DanielHeEGG/MAST/Hardware/MAST.kicad_pcb

## KiCad design Hardware/MAST.kicad_pcb (2021-07-17)

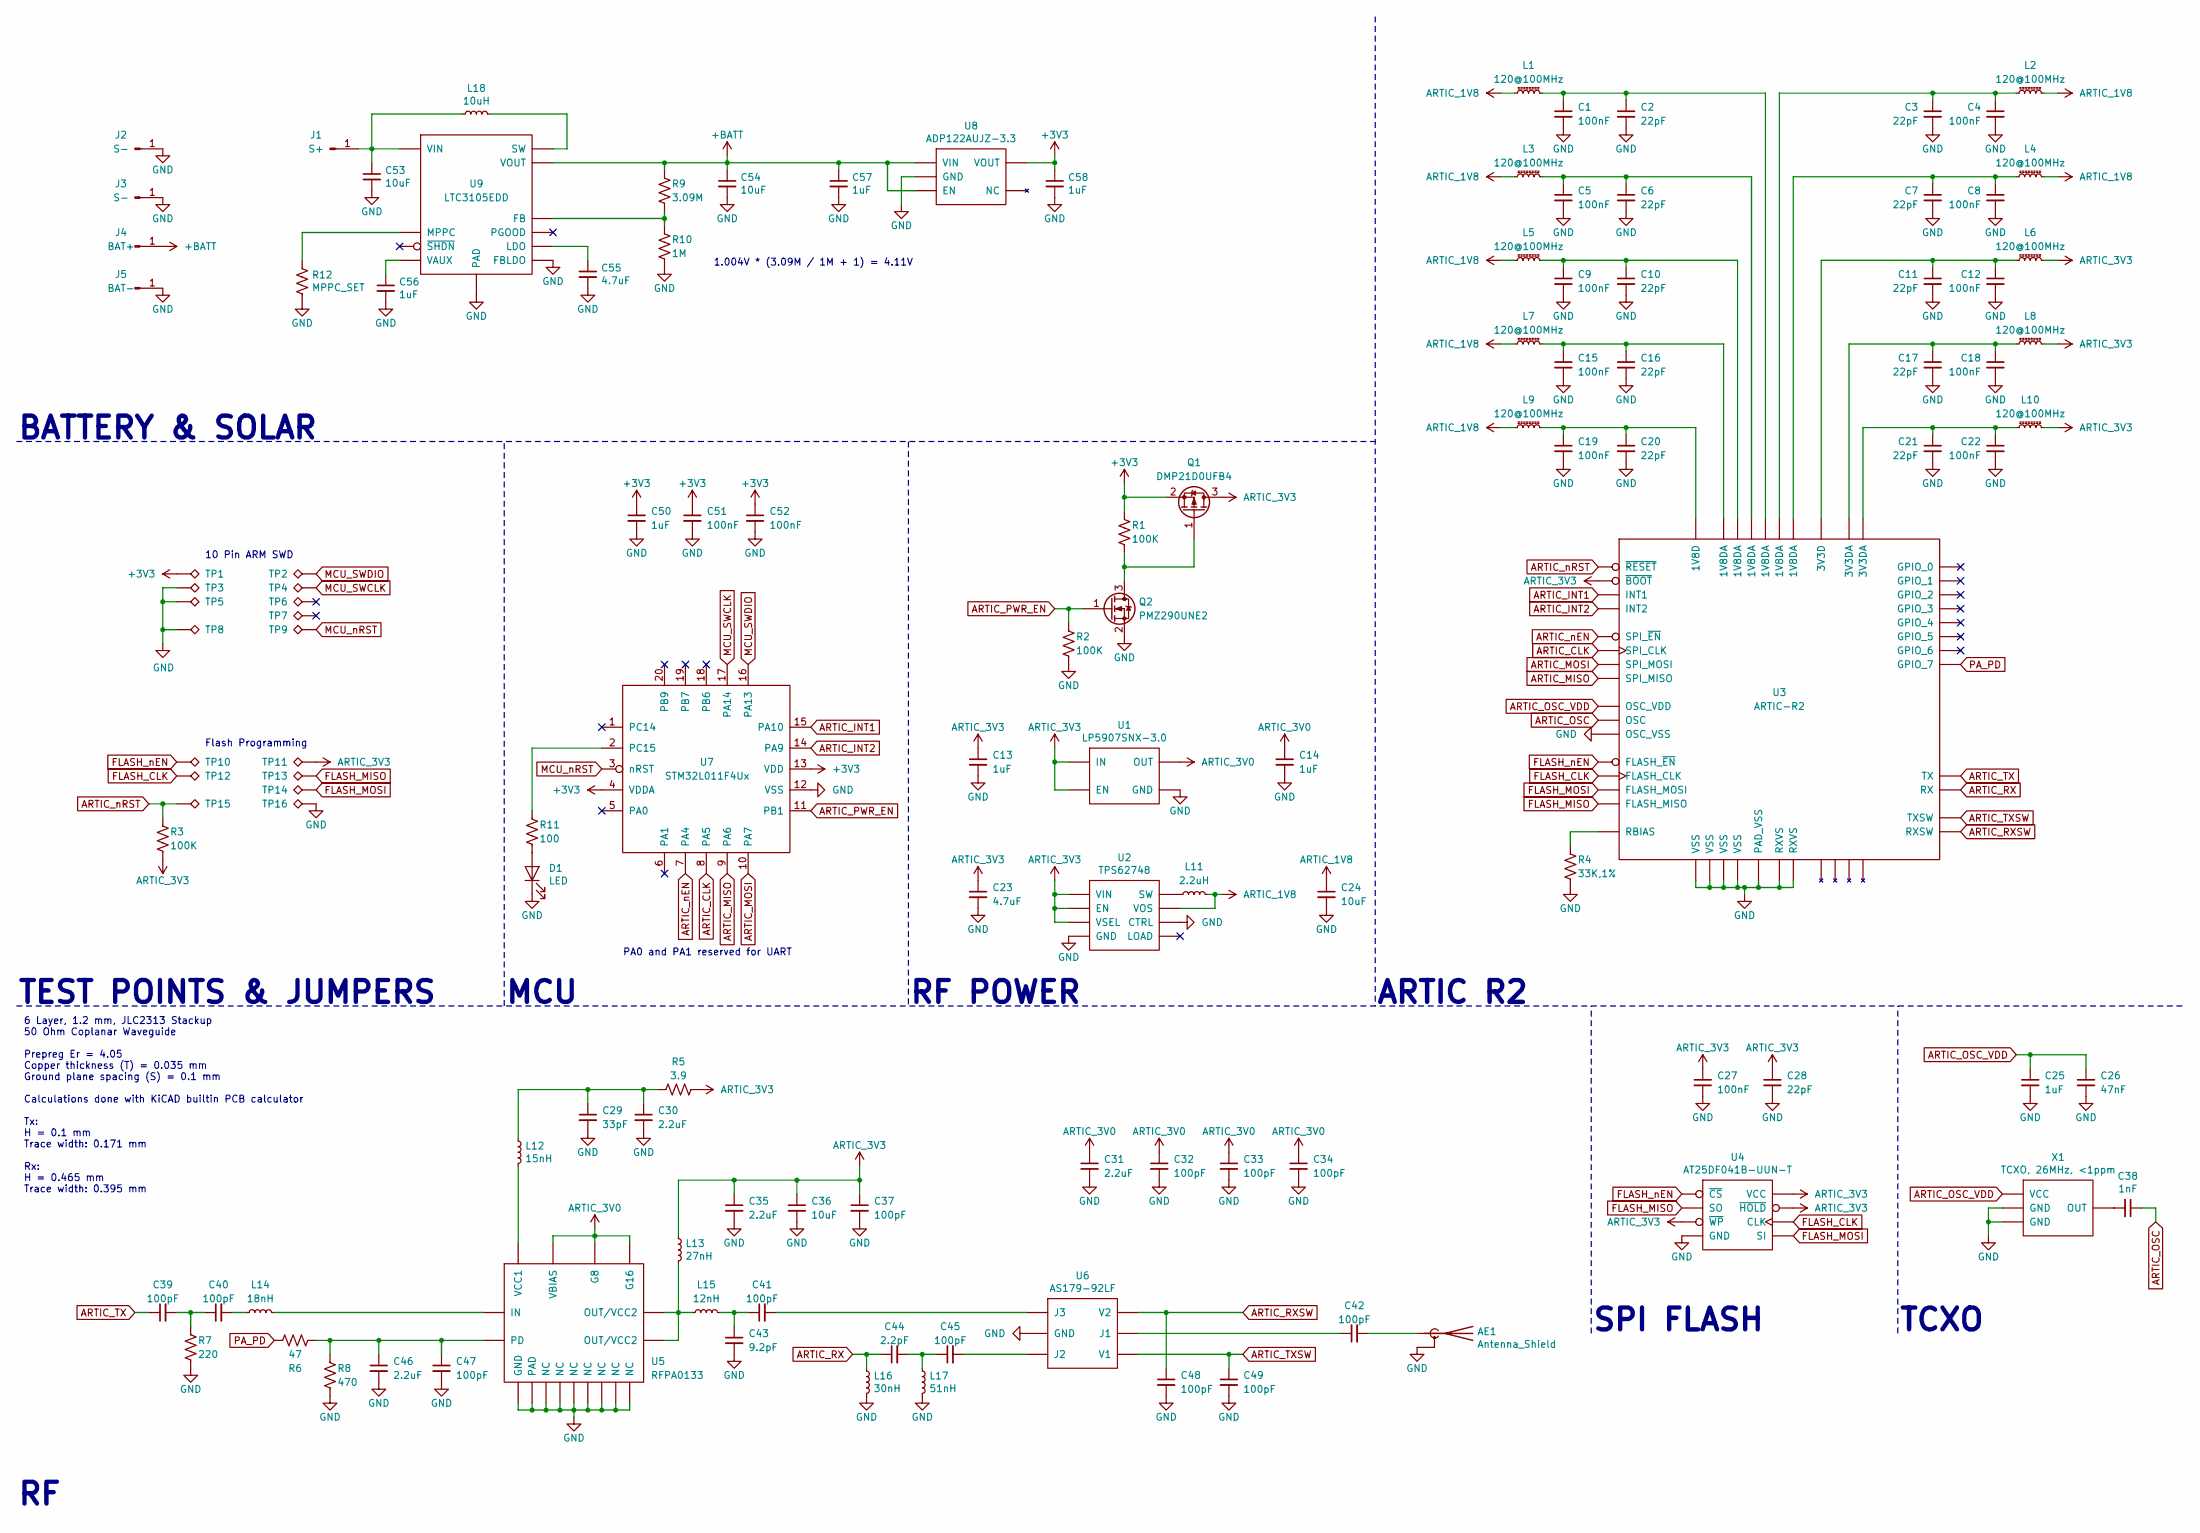
[picture p1: schematic MAST.sch]

Parts:
AE1: Antenna_Shield; U.FL_Hirose_U.FL-R-SMT-1_Vertical; Part# U.FL-R-SMT-1(10); Digikey# H11891TR-ND
C1, C4, C5, C8, C9, C12, C15, C18, C19, C22, C27, C51, C52: 100nF; C_0201_0603Metric; Part# CC0201MRX5R5BB104; LCSC# C277512
C2, C3, C6, C7, C10, C11, C16, C17, C20, C21, C28: 22pF; C_0201_0603Metric; Part# CC0201GRNPO9BN220; Digikey# 311-3681-2-ND
C13, C14, C25, C50, C56, C57, C58: 1uF; C_0201_0603Metric; Part# CC0201MRX5R5BB105; Digikey# 311-1613-2-ND
C23, C55: 4.7uF; C_0402_1005Metric; Part# CC0402KRX5R6BB475; Digikey# 311-3477-2-ND
C24, C36, C53, C54: 10uF; C_0402_1005Metric; Part# CC0402MRX5R6BB106; Digikey# 311-3480-2-ND
C26: 47nF; C_0201_0603Metric; Part# CC0201KRX5R6BB473; Digikey# 13-CC0201KRX5R6BB473TR-ND
C29: 33pF; C_0201_0603Metric; Part# CC0201JRNPO8BN330; Digikey# 311-1381-2-ND
C30, C31, C35, C46: 2.2uF; C_0402_1005Metric; Part# CC0402MRX5R6BB225; Digikey# 311-1733-2-ND
C32, C33, C34, C37, C39, C40, C41, C42, C45, C47, C48, C49: 100pF; C_0201_0603Metric; Part# CC0201JRNPO8BN101; Digikey# 311-1382-2-ND
C38: 1nF; C_0201_0603Metric; Part# CC0201KRX7R7BB102; Digikey# 311-1399-2-ND
C43: 9.2pF; C_0201_0603Metric; Part# GJM0335C1E9R2CB01D; Digikey# 490-17292-2-ND
C44: 2.2pF; C_0201_0603Metric; Part# CC0201BRNPO8BN2R2; Digikey# 311-3289-2-ND
D1: LED; LED_0402_1005Metric; Part# 16-213/SURC/S530-A3/TR8; LCSC# C136765
J1: S+; EP_5x2mm
J2, J3: S-; EP_3x2mm
J4: BAT+; EP_3x2mm
J5: BAT-; EP_3x2mm
L1, L2, L3, L4, L5, L6, L7, L8, L9, L10: 120@100MHz; L_0201_0603Metric; Part# BLM03AG121SN1D; Digikey# 490-2557-2-ND
L11: 2.2uH; L_0805_2012Metric; Part# LQM21PN2R2MC0D; Digikey# 490-4994-2-ND
L12: 15nH; L_0201_0603Metric; Part# LQP03TG15NJ02D; Digikey# 490-12895-2-ND
L13: 27nH; L_0201_0603Metric; Part# LQP03TG27NJ02D; Digikey# 490-12942-2-ND
L14: 18nH; L_0201_0603Metric; Part# LQP03TG18NJ02D; Digikey# 490-12896-2-ND
L15: 12nH; L_0201_0603Metric; Part# LQP03TG12NJ02D; Digikey# 490-12894-2-ND
L16: 30nH; L_0201_0603Metric; Part# LQP03TN30NH02D; Digikey# 490-13005-2-ND
L17: 51nH; L_0201_0603Metric; Part# LQP03TN51NH02D; Digikey# 490-13014-2-ND
L18: 10uH; L_0805_2012Metric; Part# LQM21FN100M80L; Digikey# 490-6682-2-ND
Q1: DMP21D0UFB4; SOT-883; Part# DMP21D0UFB4-7B; Digikey# DMP21D0UFB4-7BDITR-ND
Q2: PMZ290UNE2; SOT-883; Part# PMZ290UNE2YL; Digikey# 1727-2233-2-ND
R1, R2, R3: 100K; R_0201_0603Metric; Part# AC0201FR-07100KL; Digikey# YAG3411TR-ND
R4: 33K,1%; R_0201_0603Metric; Part# RC0201FR-0733KL; Digikey# YAG2282TR-ND
R5: 3.9; R_0402_1005Metric; Part# RC0402FR-073R9L; Digikey# 13-RC0402FR-073R9LTR-ND
R6: 47; R_0402_1005Metric; Part# RC0402FR-0747RL; Digikey# 311-47.0LRTR-ND
R7: 220; R_0201_0603Metric; Part# RC0201FR-07220KL; Digikey# YAG2277TR-ND
R8: 470; R_0402_1005Metric; Part# RC0402FR-07470RL; Digikey# 311-470LRTR-ND
R9: 3.09M; R_0201_0603Metric; Part# RC0201FR-073M09L; Digikey# RC0201FR-073M09L-ND
R10: 1M; R_0201_0603Metric; Part# RC0201FR-071ML; Digikey# 311-1MMTR-ND
R11: 100; R_0402_1005Metric; Part# RC0402JR-07100RL; Digikey# 311-100JRTR-ND
R12: MPPC_SET; R_0603_1608Metric
TP1, TP2, TP3, TP4, TP5, TP6, TP7, TP8, TP9, TP10, TP11, TP12, TP13, TP14, TP15, TP16: TestPoint
U1: LP5907SNX-3.0; Texas_X2SON-4_1x1mm_P0.65mm; Part# LP5907SNX-3.0/NOPB; Digikey# 296-39065-2-ND
U2: TPS62748; Texas_DSBGA-8_0.9x1.9mm_Layout2x4_P0.5mm; Part# TPS62748YFPT; Digikey# 296-43000-2-ND
U3: ARTIC-R2; QFN-48-1EP_7x7mm_P0.5mm_EP5.6x5.6mm
U4: AT25DF041B-UUN-T; WLCSP-8_1.58x1.63x0.35mm_Layout3x5_P0.35x0.4mm_Ball0.25mm_P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
U5: RFPA0133; QFN-16-1EP_3x3mm_P0.5mm_EP1.7x1.7mm; Part# RFPA0133TR7; LCSC# C470930
U6: AS179-92LF; SOT-363_SC-70-6; Part# AS179-92LF; Digikey# 863-1003-2-ND
U7: STM32L011F4Ux; ST_UFQFPN-20_3x3mm_P0.5mm; Part# STM32L011F4U6TR; Digikey# 497-17478-2-ND
U8: ADP122AUJZ-3.3; TSOT-23-5; Part# ADP122AUJZ-3.3-R7; Digikey# ADP122AUJZ-3.3-R7TR-ND
U9: LTC3105EDD; DFN-10-1EP_3x3mm_P0.5mm_EP1.65x2.38mm; Part# LTC3105EDD#TRPBF; Digikey# LTC3105EDD#TRPBFTR-ND
X1: TCXO, 26MHz, <1ppm; Crystal_SMD_2016-4Pin_2.0x1.6mm; Part# ECS-TXO-20CSMV-260-AY-TR; Digikey# 50-ECS-TXO-20CSMV-260-AY-TR-ND

Connections:
+3V3: C50.1, C51.1, C52.1, C58.1, Q1.2 (S), R1.1, TP1.1, U7.4 (VDDA), U7.13 (VDD), U8.5 (VOUT)
+BATT: C54.1, C57.1, J4.1, R9.2, U8.1 (VIN), U8.3 (EN), U9.9 (VOUT)
ARTIC_1V8: C24.1, L1.1, L2.1, L3.1, L4.1, L5.1, L7.1, L9.1, L11.2, U2.C2 (VOS)
ARTIC_3V0: C14.1, C31.1, C32.1, C33.1, C34.1, U1.1 (OUT), U5.12 (G8), U5.13 (G16), U5.16 (VBIAS)
ARTIC_3V3: C13.1, C23.1, C27.1, C28.1, C35.1, C36.1, C37.1, L6.1, L8.1, L10.1, L13.1, Q1.3 (D), R3.2, R5.1, TP11.1, U1.3 (EN), U1.4 (IN), U2.A2 (VIN), U2.B1 (EN), U2.C1 (VSEL), U3.46 (~BOOT), U4.A1 (VCC), U4.C1 (~HOLD), U4.E3 (~WP)
ARTIC_CLK: U3.3 (SPI_CLK), U7.8 (PA5)
ARTIC_INT1: U3.47 (INT1), U7.15 (PA10)
ARTIC_INT2: U3.48 (INT2), U7.14 (PA9)
ARTIC_MISO: U3.5 (SPI_MISO), U7.9 (PA6)
ARTIC_MOSI: U3.4 (SPI_MOSI), U7.10 (PA7)
ARTIC_OSC: C38.1, U3.38 (OSC)
ARTIC_OSC_VDD: C25.1, C26.1, U3.37 (OSC_VDD), X1.4 (VCC)
ARTIC_PWR_EN: Q2.1 (G), R2.1, U7.11 (PB1)
ARTIC_RX: C44.1, L16.1, U3.26 (RX)
ARTIC_RXSW: C48.1, U3.22 (RXSW), U6.6 (V2)
ARTIC_TX: C39.1, U3.34 (TX)
ARTIC_TXSW: C49.1, U3.21 (TXSW), U6.4 (V1)
ARTIC_nEN: U3.2 (SPI_~EN), U7.7 (PA4)
ARTIC_nRST: R3.1, TP15.1, U3.1 (~RESET)
FLASH_CLK: TP12.1, U3.12 (FLASH_CLK), U4.E1 (CLK)
FLASH_MISO: TP13.1, U3.14 (FLASH_MISO), U4.C3 (SO)
FLASH_MOSI: TP14.1, U3.13 (FLASH_MOSI), U4.D2 (SI)
FLASH_nEN: TP10.1, U3.15 (FLASH_~EN), U4.A3 (~CS)
GND: AE1.2 (Shield), C1.2, C2.2, C3.2, C4.2, C5.2, C6.2, C7.2, C8.2, C9.2, C10.2, C11.2, C12.2, C13.2, C14.2, C15.2, C16.2, C17.2, C18.2, C19.2, C20.2, C21.2, C22.2, C23.2, C24.2, C25.2, C26.2, C27.2, C28.2, C29.2, C30.2, C31.2, C32.2, C33.2, C34.2, C35.2, C36.2, C37.2, C43.2, C46.2, C47.2, C48.2, C49.2, C50.2, C51.2, C52.2, C53.2, C54.2, C55.2, C56.2, C57.2, C58.2, D1.1 (K), J2.1, J3.1, J5.1, L16.2, L17.2, Q2.2 (S), R2.2, R4.2, R7.1, R8.1, R10.1, R12.2, TP3.1, TP5.1, TP8.1, TP16.1, U1.2 (GND), U1.5, U2.B2 (GND), U2.D1 (CTRL), U3.25 (RXVS), U3.27 (RXVS), U3.29 (VSS), U3.30 (VSS), U3.31 (VSS), U3.32 (VSS), U3.39 (OSC_VSS), U3.49 (PAD_VSS), U4.B2 (GND), U5.1 (NC), U5.2 (GND), U5.4 (NC), U5.5 (NC), U5.7 (NC), U5.8 (NC), U5.11 (NC), U5.15 (NC), U5.17 (PAD), U6.2 (GND), U7.12 (VSS), U8.2 (GND), U9.3 (FBLDO), U9.11 (PAD), X1.1 (GND), X1.2 (GND)
MCU_SWCLK: TP4.1, U7.17 (PA14)
MCU_SWDIO: TP2.1, U7.16 (PA13)
MCU_nRST: TP9.1, U7.3 (nRST)
unnamed: AE1.1 (A), C42.2
unnamed: C1.1, C2.1, L1.2, U3.33 (1V8DA)
unnamed: C3.1, C4.1, L2.2, U3.35 (1V8DA)
unnamed: C5.1, C6.1, L3.2, U3.28 (1V8DA)
unnamed: C7.1, C8.1, L4.2, U3.40 (1V8DA)
unnamed: C9.1, C10.1, L5.2, U3.24 (1V8DA)
unnamed: C11.1, C12.1, L6.2, U3.9 (3V3D)
unnamed: C15.1, C16.1, L7.2, U3.20 (1V8DA)
unnamed: C17.1, C18.1, L8.2, U3.23 (3V3DA)
unnamed: C19.1, C20.1, L9.2, U3.6 (1V8D)
unnamed: C21.1, C22.1, L10.2, U3.36 (3V3DA)
unnamed: C29.1, C30.1, L12.1, R5.2
unnamed: C38.2, X1.3 (OUT)
unnamed: C39.2, C40.1, R7.2
unnamed: C40.2, L14.1
unnamed: C41.1, C43.1, L15.2
unnamed: C41.2, U6.1 (J3)
unnamed: C42.1, U6.5 (J1)
unnamed: C44.2, C45.1, L17.1
unnamed: C45.2, U6.3 (J2)
unnamed: C46.1, C47.1, R6.2, R8.2, U5.6 (PD)
unnamed: C53.1, J1.1, L18.1, U9.6 (VIN)
unnamed: C55.1, U9.2 (LDO)
unnamed: C56.1, U9.10 (VAUX)
unnamed: D1.2 (A), R11.1
unnamed: L11.1, U2.A1 (SW)
unnamed: L12.2, U5.14 (VCC1)
unnamed: L13.2, L15.1, U5.9 (OUT/VCC2), U5.10 (OUT/VCC2)
unnamed: L14.2, U5.3 (IN)
unnamed: L18.2, U9.7 (SW)
unnamed: Q1.1 (G), Q2.3 (D), R1.2
unnamed: R4.1, U3.41 (RBIAS)
unnamed: R9.1, R10.2, U9.1 (FB)
unnamed: R11.2, U7.2 (PC15)
unnamed: R12.1, U9.5 (MPPC)
PA_PD: R6.1, U3.7 (GPIO_7)

Notes on the sheet:
ARTIC R2
SPI FLASH
RF POWER
6 Layer, 1.2 mm, JLC2313 Stackup 50 Ohm Coplanar Waveguide Prepreg Er = 4.05 Copper thickness (T) = 0.035 mm Ground plane spacing (S) = 0.1 mm Calculations done with KiCAD builtin PCB calculator Tx: H = 0.1 mm Trace width: 0.171 mm Rx: H = 0.465 mm Trace width: 0.395 mm
PA0 and PA1 reserved for UART
MCU
TEST POINTS & JUMPERS
TCXO
Flash Programming
10 Pin ARM SWD
BATTERY & SOLAR
1.004V * (3.09M / 1M + 1) = 4.11V

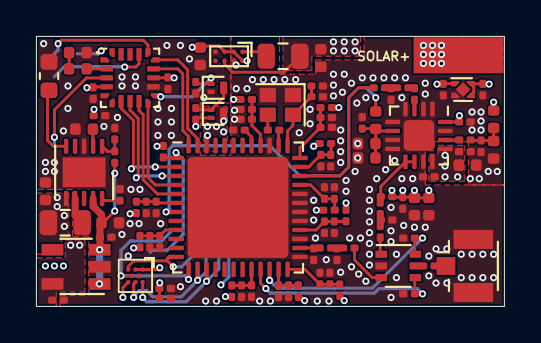
[picture p2: board MAST.kicad_pcb from above]

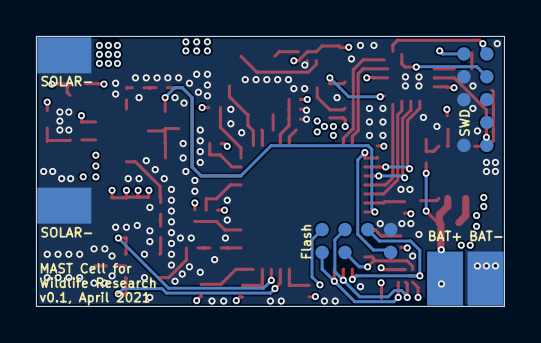
[picture p3: board MAST.kicad_pcb from below]

Board: 6 copper layers, 26.0 x 15.0 mm, 123 parts (20 on the bottom side), 63 nets.
