DanielHeEGG/MAST/(commit log)

2021-06-30 Organize F.Fab layer for clearer PCB layout
    [MAST.kicad_pcb]
2021-06-30 Increase silkscreen text size & removed some text
    [MAST.kicad_pcb]
2021-07-16 Convert all vias to through hole for cost reduction
    [MAST.kicad_pcb]
2021-07-17 Fix flash chip orientation
    [MAST.kicad_pcb, MAST.sch]
2021-07-17 Improve RF 1.8V & 3.3V rail power delivery
    [MAST.kicad_pcb]
2021-07-17 Enable MPPC on solar charger
    [MAST.kicad_pcb, MAST.sch]
2021-07-18 Move fabrication files to seperate root folder
    [MAST_BOM.csv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]
